leo-cabezas/earendil-SAR-system/docs/images/magnetometer_calibration.png

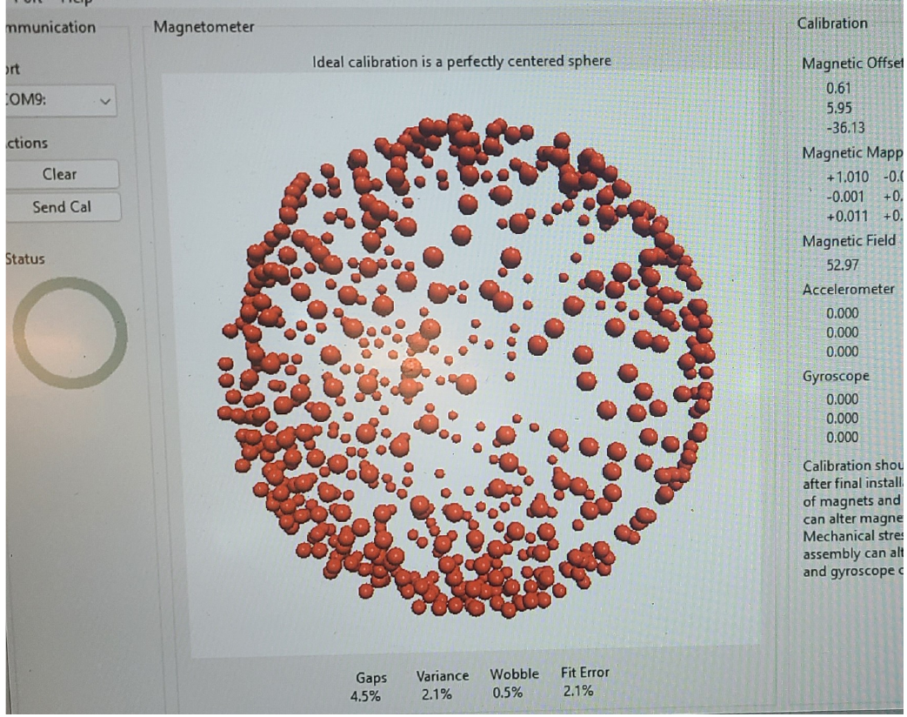
docs/images/magnetometer_calibration.png
