leo-cabezas/earendil-SAR-system/src/tasks/earendil_gps.cpp

#include <earendil_gps.h>

Adafruit_GPS GPS(&GPSSerial);

void vGPS(void* pvParameters){
  SemaphoreHandle_t g_printMutex = (SemaphoreHandle_t)pvParameters;

  vTaskDelay(pdMS_TO_TICKS(5000));

  printf("============= BEGIN GPS TASK ==============\n");
  
  uint32_t timer = millis();

  Serial.println("Adafruit GPS library basic parsing test!");

  // 9600 NMEA is the default baud rate for Adafruit MTK GPS's- some use 4800
  GPS.begin(9600); printf("Line 17 OK\n");
  // uncomment this line to turn on RMC (recommended minimum) and GGA (fix data) including altitude
  GPS.sendCommand(PMTK_SET_NMEA_OUTPUT_RMCGGA); printf("Line 18 OK\n");
  // uncomment this line to turn on only the "minimum recommended" data
  //GPS.sendCommand(PMTK_SET_NMEA_OUTPUT_RMCONLY);
  // For parsing data, we don't suggest using anything but either RMC only or RMC+GGA since
  // the parser doesn't care about other sentences at this time
  // Set the update rate
  GPS.sendCommand(PMTK_SET_NMEA_UPDATE_1HZ); printf("Line 25 OK\n");
  // For the parsing code to work nicely and have time to sort thru the data, and
  // print it out we don't suggest using anything higher than 1 Hz

  // Request updates on antenna status, comment out to keep quiet
  GPS.sendCommand(PGCMD_ANTENNA); printf("Line 30 OK\n");

  delay(1000); printf("Line 32 OK\n");

  // Ask for firmware version
  GPSSerial.println(PMTK_Q_RELEASE); printf("Line 35 OK\n");

  
  while (1){ // printf("Inside task loop!\n");
    // read data from the GPS in the 'main loop'
    char c = GPS.read();
    // if you want to debug, this is a good time to do it!
    if (GPSECHO)
      if (c) Serial.print(c);
    // if a sentence is received, we can check the checksum, parse it...
    if (GPS.newNMEAreceived()) {
      // a tricky thing here is if we print the NMEA sentence, or data
      // we end up not listening and catching other sentences!
      // so be very wary if using OUTPUT_ALLDATA and trying to print out data
      Serial.print(GPS.lastNMEA()); // this also sets the newNMEAreceived() flag to false
      if (!GPS.parse(GPS.lastNMEA())) // this also sets the newNMEAreceived() flag to false
        printf("FAILED TO PARSE!"); // we can fail to parse a sentence in which case we should just wait for another
    }

    // approximately every 2 seconds or so, print out the current stats
    if (millis() - timer > 2000) {
      timer = millis(); // reset the timer
      Serial.print("\nTime: ");
      if (GPS.hour < 10) { Serial.print('0'); }
      Serial.print(GPS.hour, DEC); Serial.print(':');
      if (GPS.minute < 10) { Serial.print('0'); }
      Serial.print(GPS.minute, DEC); Serial.print(':');
      if (GPS.seconds < 10) { Serial.print('0'); }
      Serial.print(GPS.seconds, DEC); Serial.print('.');
      if (GPS.milliseconds < 10) {
        Serial.print("00");
      } else if (GPS.milliseconds > 9 && GPS.milliseconds < 100) {
        Serial.print("0");
      }
      Serial.println(GPS.milliseconds);
      Serial.print("Date: ");
      Serial.print(GPS.day, DEC); Serial.print('/');
      Serial.print(GPS.month, DEC); Serial.print("/20");
      Serial.println(GPS.year, DEC);
      Serial.print("Fix: "); Serial.print((int)GPS.fix);
      Serial.print(" quality: "); Serial.println((int)GPS.fixquality);
      if (GPS.fix) {
        Serial.print("Location: ");
        Serial.print(GPS.latitude, 4); Serial.print(GPS.lat);
        Serial.print(", ");
        Serial.print(GPS.longitude, 4); Serial.println(GPS.lon);
        Serial.print("Speed (knots): "); Serial.println(GPS.speed);
        Serial.print("Angle: "); Serial.println(GPS.angle);
        Serial.print("Altitude: "); Serial.println(GPS.altitude);
        Serial.print("Satellites: "); Serial.println((int)GPS.satellites);
        Serial.print("Antenna status: "); Serial.println((int)GPS.antenna);
      }
    }
  }
}
