leo-cabezas/earendil-SAR-system/src/tasks/earendil_altimeter.cpp

#include <earendil_altimeter.h>

Adafruit_BMP3XX bmp;

void vAltimeter(void* pvParameters){
  (void) pvParameters;
  
  vTaskDelay(pdMS_TO_TICKS(5000));

  Serial.println("Adafruit BMP388 / BMP390 test");

  if (!bmp.begin_I2C()) {   // hardware I2C mode, can pass in address & alt Wire
    Serial.println("Could not find a valid BMP3 sensor, check wiring!");
    while (1);
  }

  // Set up oversampling and filter initialization
  bmp.setTemperatureOversampling(BMP3_OVERSAMPLING_8X);
  bmp.setPressureOversampling(BMP3_OVERSAMPLING_4X);
  bmp.setIIRFilterCoeff(BMP3_IIR_FILTER_COEFF_3);
  bmp.setOutputDataRate(BMP3_ODR_50_HZ);
  
  while (1){
    if (! bmp.performReading()) {
      Serial.println("Failed to perform reading :(");
      while (1);
    }
    
    Serial.print("Temperature = ");
    Serial.print(bmp.temperature);
    Serial.println(" *C");

    Serial.print("Pressure = ");
    Serial.print(bmp.pressure / 100.0);
    Serial.println(" hPa");

    Serial.print("Approx. Altitude = ");
    Serial.print(bmp.readAltitude(SEALEVELPRESSURE_HPA));
    Serial.println(" m");

    Serial.println();
    delay(2000);
  }
}
