leo-cabezas/earendil-SAR-system/src/tasks/earendil_magnetometer.cpp

#include <earendil_magnetometer.h>

Adafruit_MMC5603 mag = Adafruit_MMC5603();

void vCompass(void* pvParameters){
  Serial.println("Adafruit_MMC5603 Magnetometer Compass");
  Serial.println("");

  /* Initialise the sensor */
  if (!mag.begin(MMC56X3_DEFAULT_ADDRESS, &Wire)) {  // I2C mode
    /* There was a problem detecting the MMC5603 ... check your connections */
    Serial.println("Ooops, no MMC5603 detected ... Check your wiring!");
    while (1) delay(10);
  }

  while(1){
    /* Get a new sensor event */
    sensors_event_t event;
    mag.getEvent(&event);

    float Pi = 3.14159;

    // Calculate the angle of the vector y,x
    float heading = (atan2(event.magnetic.y,event.magnetic.x) * 180) / Pi;

    // Normalize to 0-360
    if (heading < 0)
    {
      heading = 360 + heading;
    }
    Serial.print("Compass Heading: ");
    Serial.println(heading);
    delay(500);
  }
}
