leo-cabezas/earendil-SAR-system/(commit log)

2026-03-03 Create README.md
    Created README for the new directory Handheld_Prototype. The codebase for the prototype will be added shortly.
2026-03-03 Create hh_proto.ino
    This is the top-level file for compiling this with the Arduino framework.
2026-03-22 Moved .gitignore into /build, and changed contents. Added an old arduino_compat header.
2026-03-30 Added to magnetometer
2026-03-30 Added gyroscope code. Not tested. Turn off gyroscope when testing other modules.
2026-04-01 Added interrupt stuff in radio
2026-04-06 Leo and I added button controls and interrupts for switching the UI and menu buttons
2026-04-06 Leo and I made changes to the display, adding Buttons and interrupts
2026-04-07 Accelerometer/Gyroscope calibration and periodic readings are working.
2026-04-08 Added first steps of sending calibration messages to LCD screen from gyro
2026-04-08 Started on calibration integration
2026-04-08 buttons working, calibration test flags are showing up, now its time to get the queue to feed into the calibrator for instructions
2026-04-13 begun magnetometer implementation and sueperated out tasks in display
2026-04-14 Leo and I made improvements to the heading angle, magnetometer calibration code still being finalized
2026-04-14 Added a mutex library, added spi mutex support. spi mutex solved bus contention b/w display and radio modules.
2026-04-15 minor changes to magnetometer code
2026-04-15 temporarily blocked out magnetometr stuff for better handling of interrupts. using tasknotifywait instead of tasknotifytake
2026-04-15 adjustments to the magnetometer clibration procedure
2026-04-21 Added encodeGPSData() and decodeGPSData() functions in Earendil_Radio. Tested data TX/RX between handheld and node prototypes with success, although there is some SPI bus contention b/w display and r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
2026-04-25 adjustments to the magnetometer clibration procedure along with adding a switch case for the clibration
2026-04-25 fixed some bugs, magnetometer needed to be able to see the mutexes in main so I added the library so it could see
2026-04-28 Gyroscope compatability fix, attemptign integration with magnetometer
2026-05-01 Node SDCard, GPS, Altimeter ready to be compiled and run together. Radio will need altered to accomodate new sea-level pressure data.
2026-05-02 added the needed task stuff to the magnetometer
2026-05-02 Radio functionality updated to include support for altimeter calibration. Altimeter functionality included to receive calibration from radio data.
2026-05-02 Fixed serial output issue. Altimeter and AccelGyro now output via serial. Next step is testing the cal values for the gyro to see if we can hardcode the offsets.
